6B726B76636C76/PLFM_RADAR/(commit log)

2026-03-15 Fix synthesis blockers in 9 RTL files for Vivado compatibility
    Guard all $display/$error/$time calls with ifdef SIMULATION in:
    - chirp_memory_loader_param.v (initial + always block debug prints)
    - cic_decimator_4x_enhanced.v (5 saturation/overflow displays + monitor block)
    - ddc_400m.v (FIR/baseband debug monitor block)
    - fft_1024_inverse.v (IFFT config debug block)
    - matched_filter_multi_segment.v (16 state machine displays + monitor)
    - nco_400m_enhanced.v (initial block debug print)
    - radar_receiver_final.v (frame/chirp counter displays)
    Replace SystemVerilog constructs with Verilog-2001:
    - usb_data_interface.v (typedef enum -> localparam + reg)
    - usb_packet_analyzer.v (typedef enum -> lo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
    [chirp_memory_loader_param.v, cic_decimator_4x_enhanced.v, ddc_400m.v, fft_1024_inverse.v, matched_filter_multi_segment.v, nco_400m_enhanced.v, radar_receiver_final.v, usb_data_interface.v]
2026-04-07 docs: update constraints README with USB_MODE architecture and build guide
    Add USB Interface Architecture section documenting the USB_MODE parameter,
    generate block mechanism, per-target wrapper pattern, FT2232H pin map, and
    build quick-reference. Update top modules table (50T now uses
    radar_system_top_50t), bank voltage tables, and signal differences to
    reflect the FT2232H/FT601 dual-interface design.
2026-04-08 fix: regenerate golden hex for dual-16pt Doppler and add real-data TBs to regression
    Regenerate all real-data golden reference hex files against the current
    dual 16-point FFT Doppler architecture (staggered-PRI sub-frames).
    The old hex files were generated against the previous 32-point single-FFT
    architecture and caused 2048/2048 mismatches in both strict real-data TBs.
    Changes:
    - Regenerate doppler_ref_i/q.hex, fullchain_doppler_ref_i/q.hex, and all
    downstream golden files (MTI, DC notch, CFAR) via golden_reference.py
    - Add tb_doppler_realdata (exact-match, ADI CN0566 data) to regression
    - Add tb_fullchain_realdata (exact-match, decim->Doppler chain) to regression
    - Both TBs now pass: 20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
2026-04-16 Added silk screen and headers description
    [RADAR_Main_Board.brd]
